mickey9801/esp32_iot_door_lock/session_4/README.md

# 4. 連接 Wi-Fi
Copyright &copy; 2019 Mickey Chan. ALL RIGHTS RESERVED.  

## AP、STA 及 AP＋STA 模式

## mDNS 與 Bonjour

## 透過 NTP 同步時鐘

## 架設網頁伺服器

## 電門網絡服務
