mickey9801/esp32_iot_door_lock/(commit log)

2019-02-09 Update README.md
    Added wiring picture and parts list
2019-03-02 Updated Session 1
    - Added programming example for session 1;
    - Fixed session 3 markdown filename
    [session_1.ino]
2019-03-04 Update sessions content
    Added surge voltage in session 2
2019-03-06 Fix title
    - Correct "EPS32" to "ESP32"
    - Add description about auto-relock delay
    [lock.cpp]
